TannerHollis/FestivalNecklace/Angled View.png

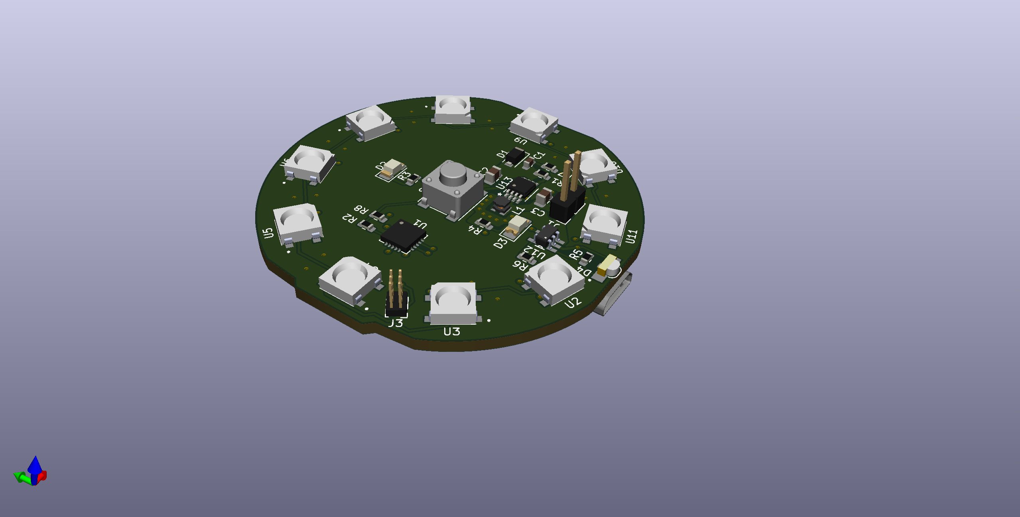
Angled View.png
