TannerHollis/FestivalNecklace/Bottom View.png

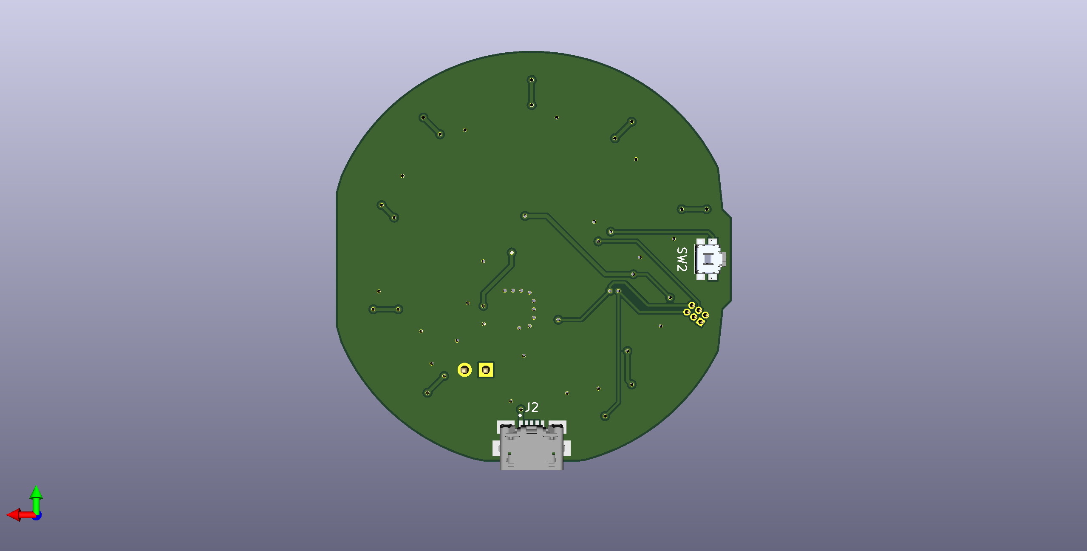
Bottom View.png
