TannerHollis/FestivalNecklace/README.md

# FestivalNecklace
 Fun RGB ATTiny Festival Necklace
