TannerHollis/FestivalNecklace/Board Dimensions.png

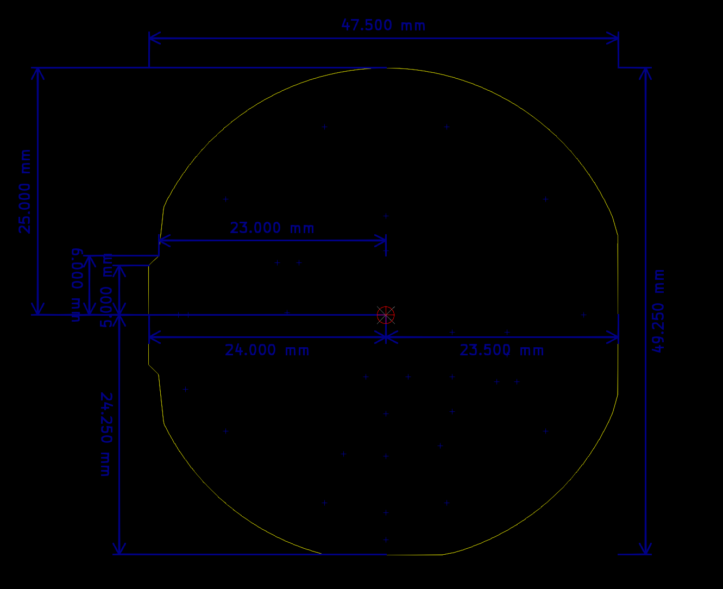
Board Dimensions.png
