TannerHollis/FestivalNecklace/Board Outline.png

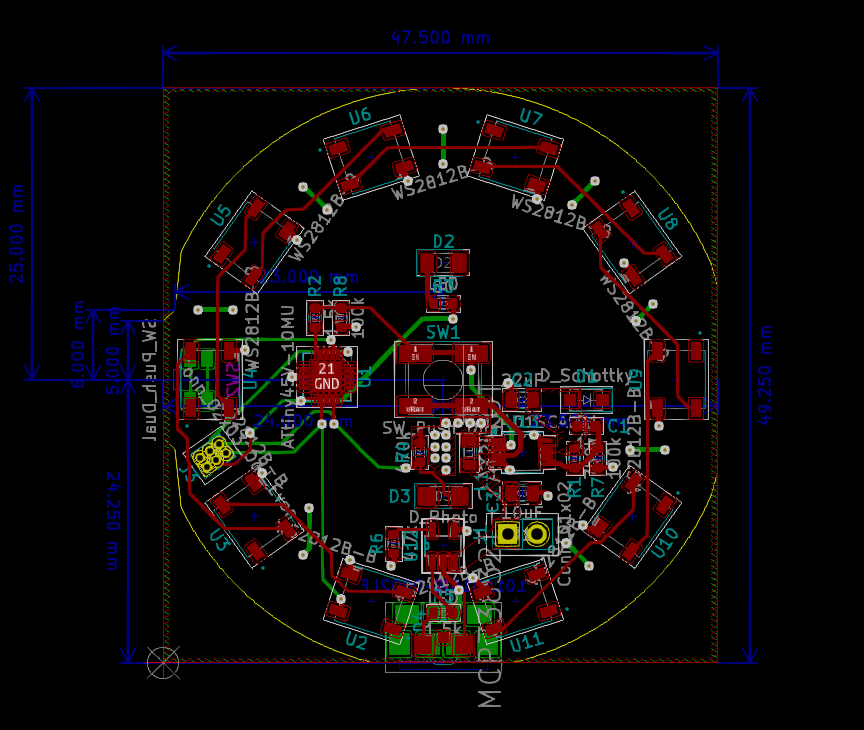
Board Outline.png
