TannerHollis/FestivalNecklace/Programmer_Pinout.jpg

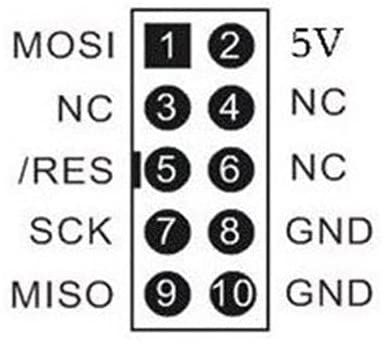
Programmer_Pinout.jpg
