TannerHollis/FestivalNecklace/Switch View.png

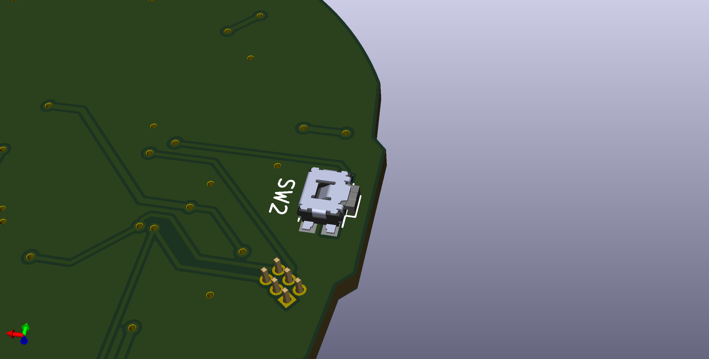
Switch View.png
