TannerHollis/FestivalNecklace/Top View.png

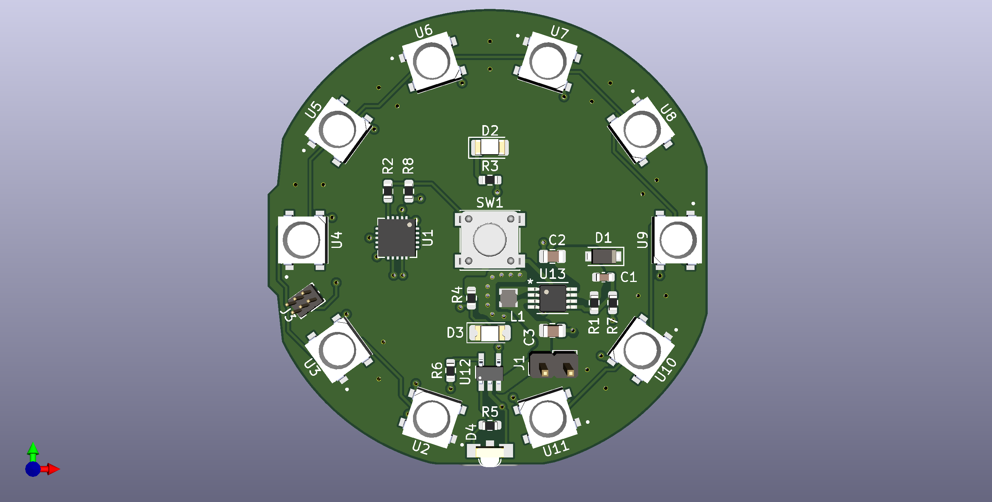
Top View.png
