TannerHollis/FestivalNecklace/FestivalNecklace_BOM_R1.xlsx

Item | Qty | Reference(s) | Value | LibPart | Footprint | DK_PN | MANUFACTURER | PARTNO | PREVIOUSLY ORDERD | AVAILABLE | PRICE | PRICE PER QUANTITY | QUANTITY NEEDED | DIGIKEY PARTNUMBER
1 | 1 | C1 | 1n | Device:C | Capacitor_SMD:C_0603_1608Metric | 1276-1018-1-ND | Samsung Electro-Mechanics | CL10B102KB8NNNC | Yes | 50 | $0.85 | $0.017
2 | 1 | C2 | 22uF | Device:C | Capacitor_SMD:C_0805_2012Metric | 1276-6460-1-ND | Samsung Electro-Mechanics | CL21A226MQQNNNG | Yes | 50 | $2.88 | $0.058
3 | 1 | C3 | 10uF | Device:C | Capacitor_SMD:C_0805_2012Metric | 1276-1298-1-ND | Samsung Electro-Mechanics | CL21A106MQFNNNE | Yes | 50 | $2.14 | $0.043
4 | 1 | D1 | D_Schottky | Device:D_Schottky | Diode_SMD:D_SOD-123F | 1727-5192-1-ND | Nexperia USA Inc. | PMEG2010ER | Yes | 50 | $15.95 | $0.319
5 | 1 | D2 | LED | Device:LED | LED_SMD:LED_1206_3216Metric | 1080-1357-1-ND | Everlight Electronics Co Ltd | IR26-21C/L110/TR8 | Yes | 100 | $9.47 | $0.095
6 | 1 | D3 | D_Photo | Device:D_Photo | LED_SMD:LED_1206_3216Metric_Castellated | 3147-B1501PD--H9B000113U1930CT-ND |  | B1501PD--H9B000113U1930 | Yes | 50 | $7.00 | $0.140
7 | 1 | D4 | LED | Device:LED | FestivalNecklace:APA3010SECK | 754-1842-1-ND | Kingbright | APA3010SECK-GX | Yes | 50 | $14.35 | $0.287
8 | 1 | J1 |  |  |  |  |  |  |  |  |  | $0.000
9 | 1 | J2 | 10118192-0002LF | FestivalNecklace:10118192-0002LF | FestivalNecklace:AMPHENOL_10118192-0002LF | 609-5379-1-ND | Amphenol ICC (FCI) | 10118192-0002LF | Yes | 25 | $8.83 | $0.353
10 | 1 | J3 |  |  |  |  |  |  |  |  |  | $0.000
11 | 1 | L1 | 2.2u | Device:L | Inductor_SMD:L_0805_2012Metric | 1292-WLPH201610M2R2PPCT-ND | Walsin Technology Corporation | WLPH201610M2R2PP | Yes | 50 | $3.78 | $0.076
12 | 1 | R1 | 750k | Device:R | Resistor_SMD:R_0603_1608Metric | RMCF0603FT750KCT-ND | Stackpole Electronics Inc | RMCF0603FT750K | Yes | 100 | $0.68 | $0.007
13 | 2 | R2, R5 | 1.5k | Device:R | Resistor_SMD:R_0603_1608Metric | 311-1.50KHRCT-ND | YAGEO | RC0603FR-071K5L | Yes | 100 | $0.97 | $0.019
14 | 1 | R3 | 47 | Device:R | Resistor_SMD:R_0603_1608Metric | 10-ERJ-H3GJ470VCT-ND | Panasonic Electronic Components | ERJ-H3GJ470V | Yes | 100 | $5.38 | $0.054
15 | 1 | R4 | 470k | Device:R | Resistor_SMD:R_0603_1608Metric | A129720CT-ND | TE Connectivity Passive Product | CRGCQ0603F470K | Yes | 100 | $1.45 | $0.014
16 | 1 | R6 | 4.7k | Device:R | Resistor_SMD:R_0603_1608Metric | RR08P4.7KDCT-ND | Susumu | RR0816P-472-D | Yes | 100 | $3.42 | $0.034
17 | 2 | R7, R8 | 100k | Device:R | Resistor_SMD:R_0603_1608Metric | CR0603-JW-104ELFCT-ND | Bourns Inc. | CR0603-JW-104ELF | Yes | 100 | $0.36 | $0.007
18 | 1 | SW1 | SW_Push_Dual | Switch:SW_SPST | FestivalNecklace:TL3301NF260QG | EG4374CT-ND | E-Switch | TL3301AF160QJ | Yes | 50 | $21.54 | $0.431
19 | 1 | SW2 | SW_Push_Dual | Switch:SW_SPST | FestivalNecklace:EVQ-P7C01P | P16765CT-ND | Panasonic Electronic Components | EVQ-P7C01P | Yes | 50 | $14.48 | $0.290
20 | 1 | U1 | ATtiny45V-10MU | MCU_Microchip_ATtiny:ATtiny45V-10MU | Package_DFN_QFN:QFN-20-1EP_4x4mm_P0.5mm_EP2.6x2.6mm | ATTINY45V-10MU-ND | Microchip Technology | ATTINY45V-10MU | Yes | 25 | $44.85 | $1.794
21 | 10 | U2, U3, U4, U5, U6, U7, U8, U9, U10, U11 | WS2812B-B | FestivalNecklace:WS2812B-B | FestivalNecklace:LED_WS2812B-B |  | Worldsemi |  | Yes | 150 | $75.00 | $5.000
22 | 1 | U12 | MCP73832T-2ACI_OT | FestivalNecklace:MCP73832T-2ACI_OT | FestivalNecklace:SOT95P270X145-5N | MCP73832T-2ACI/OTCT-ND | Microchip Technology | MCP73832T-2ACI/OT | Yes | 25 | $15.75 | $0.630
23 | 1 | U13 | PAM2401SCADJ | FestivalNecklace:PAM2401SCADJ | FestivalNecklace:PAM2401SCADJ | PAM2401SCADJDICT-ND | Diodes Incorporated | PAM2401SCADJ | Yes | 25 | $22.26 | $0.890
 |  |  |  |  |  |  |  | Subtotal |  |  | $271.39 | $10.56
