TannerHollis/FestivalNecklace/PCBWay_BOM_A0.xlsx

 |  |  | xxxx xxxx xxxxx xxPCS BOM (Sample Bill of Materials)
Item # | *Designator | *Qty | Manufacturer | *Mfg Part # | Description / Value | *Package/Footprint | Type | Your Instructions / Notes | Digikey PartNumber
1 | D1 | 1 | Nexperia USA Inc. | PMEG2010ER | D | D_SOD-123F | SMD |  | 1727-5192-1-ND
2 | U2, U3, U4, U5, U7 | 5 |  | WS2812b | RGB_LED | WS2812b (5050) | SMD
3 | D6 | 1 | Everlight Electronics Co Ltd | IR26-21C/L110/TR8 | IR_LED | LED_1206_3216Metric | SMD |  | 1080-1357-1-ND
4 | D8 | 1 | Harvatek Corporation | B1501PD--H9B000113U1930 | D_PHOTO | LED_1206_3216Metric_Castellated | SMD |  | 3147-B1501PD--H9B000113U1930TR-ND
5 | J1 | 1 |  |  | Conn_01x02 |  | THT | DNP
6 | J2 | 1 |  |  | Conn_02x03_Odd_Even |  | THT | DNP
7 | Q1 | 1 | Vishay Siliconix | SI1021R-T1-GE3 | MOSFET N-CH 20V 200MA SSM | SC-75, SOT-416 | SMD |  | SI1021R-T1-GE3CT-ND
8 | R1 | 1 | Bourns Inc. | CR0603-JW-104ELF | 100k | R_0603_1608Metric | SMD |  | CR0603-JW-104ELFCT-ND
9 | R2 | 1 | YAGEO | RC0603FR-071K5L | 1.5k | R_0603_1608Metric | SMD |  | 311-1.50KHRCT-ND
10 | R3 | 1 | Panasonic Electronic Components | ERJ-H3GJ470V | 47 | R_0603_1608Metric | SMD |  | 10-ERJ-H3GJ470VCT-ND
11 | R4 | 1 | TE Connectivity Passive Product | CRGCQ0603F470K | 470k | R_0603_1608Metric | SMD |  | A129720CT-ND
12 | SW1 | 1 | E-Switch | TL3301NF260QJ | SW_Push | TL3301NF260QG | SMD |  | EG6055CT-ND
13 | SW2 | 1 | Panasonic Electronic Components | EVQ-P7C01P | SW_Push | EVQ-P7C01P | SMD |  | P16765CT-ND
14 | U1 | 1 | Microchip Technology | ATTINY13V-10MMUR | IC MCU 8BIT 1KB FLASH 10MLP | DFN-10-1EP_3x3mm_P0.5mm_EP1.75x2.7mm | SMD |  | ATTINY13V-10MMURCT-ND
Need a quick and accurante quote? Need an efficient production? Please read SMT Ordering Necessary Files & Info in 1 minute. Thank you very much! (https://www.pcbway.com/smt_ordering_guide.html)
Click for Instructions on How to Create a BOM (https://www.pcbway.com/blog/PCB_Assembly/How_to_Build_a_BOM__Bill_Of_Materials_.html)
