TannerHollis/FestivalNecklace/PCBWay_BOM_A1.xlsx

 |  |  | FESTIVAL NECKLACE 20PCS BOM
Item # | *Designator | *Qty | Manufacturer | *Mfg Part # | Description / Value | *Package/Footprint | Type | Your Instructions / Notes | Digikey PartNumber
1 | C1 | 1 | Samsung Electro-Mechanics | CL10B102KB8NNNC | CAP CER 1000PF 50V X7R 0603 | C_0603_1608Metric | SMD |  | 1276-1018-1-ND
2 | C2 | 1 | Samsung Electro-Mechanics | CL21A226MQQNNNG | CAP CER 22UF 6.3V X5R 0805 | C_0805_2012Metric | SMD |  | 1276-6460-1-ND
3 | C3 | 1 | Samsung Electro-Mechanics | CL21A106MQFNNNE | CAP CER 10UF 6.3V X5R 0805 | C_0805_2012Metric | SMD |  | 1276-1298-1-ND
4 | D1 | 1 | Nexperia USA Inc. | PMEG2010ER | DIODE SCHOTTKY 20V 1A CFP3 | D_SOD-123F | SMD |  | 1727-5192-1-ND
5 | D2 | 1 | Everlight Electronics Co Ltd | IR26-21C/L110/TR8 | EMITTER IR 940NM 65MA 1206 | LED_1206_3216Metric | SMD |  | 1080-1357-1-ND
6 | D3 | 1 |  | B1501PD--H9B000113U1930 | Photodiode 940nm 6ns - 1206 (3216 Metric) | LED_1206_3216Metric_Castellated | SMD |  | 3147-B1501PD--H9B000113U1930CT-ND
7 | D4 | 1 | Kingbright | APA3010SECK-GX | LED ORANGE CLEAR SMD R/A | 2-SMD, No Lead | SMD |  | 754-1842-1-ND
8 | J1 | 1 |  |  |  |  | THT | DNP
9 | J2 | 1 | Amphenol ICC (FCI) | 10118192-0002LF | CONN RCPT USB2.0 MICRO B SMD R/A | USB_Micro_B-SMD | SMD |  | 609-5379-1-ND
10 | J3 | 1 |  |  |  |  | THT | DNP
11 | L1 | 1 | Taiyo Yuden | NRS2012T2R2MGJ | FIXED IND 2.2UH 1.37A 107MOHM SM | 2-SMD, No Lead | SMD |  | 587-3450-1-ND
12 | R1 | 1 | Stackpole Electronics Inc | RMCF0603FT750K | RES 750K OHM 1% 1/10W 0603 | R_0603_1608Metric | SMD |  | RMCF0603FT750KCT-ND
13 | R2, R5 | 2 | YAGEO | RC0603FR-071K5L | RES 1.5K OHM 1% 1/10W 0603 | R_0603_1608Metric | SMD |  | 311-1.50KHRCT-ND
14 | R3 | 1 | Panasonic Electronic Components | ERJ-H3GJ470V | RES 47 OHM 5% 1/8W 0603 | R_0603_1608Metric | SMD |  | 10-ERJ-H3GJ470VCT-ND
15 | R4 | 1 | TE Connectivity Passive Product | CRGCQ0603F470K | RES 470K OHM 1% 1/10W 0603 | R_0603_1608Metric | SMD |  | A129720CT-ND
16 | R6 | 1 | Susumu | RR0816P-472-D | RES SMD 4.7K OHM 0.5% 1/16W 0603 | R_0603_1608Metric | SMD |  | RR08P4.7KDCT-ND
17 | R7, R8 | 2 | Bourns Inc. | CR0603-JW-104ELF | RES SMD 100K OHM 5% 1/10W 0603 | R_0603_1608Metric | SMD |  | CR0603-JW-104ELFCT-ND
18 | SW1 | 1 | E-Switch | TL3301AF160QJ | SWITCH TACTILE SPST-NO 0.05A 12V | 6mmx6mm-SMD-Jlead | SMD |  | EG4374CT-ND
19 | SW2 | 1 | Panasonic Electronic Components | EVQ-P7C01P | SWITCH TACTILE SPST-NO 0.05A 12V | 4.7mmx2.9mm-SMD-RightAngle | SMD |  | P16765CT-ND
20 | U1 | 1 | Microchip Technology | ATTINY45V-10MU | IC MCU 8BIT 4KB FLASH 20QFN | QFN-20-1EP_4x4mm_P0.5mm_EP2.6x2.6mm | SMD |  | ATTINY45V-10MU-ND
21 | U2, U3, U4, U5, U6, U7, U8, U9, U10, U11 | 10 | Worldsemi |  |  | LED_50mmx50mm | SMD
22 | U12 | 1 | Microchip Technology | MCP73832T-2ACI/OT | IC BATT CNTL LI-ION 1CEL SOT23-5 | SOT95P270X145-5N | SMD |  | MCP73832T-2ACI/OTCT-ND
23 | U13 | 1 | Diodes Incorporated | PAM2401SCADJ | IC REG BOOST ADJUSTABLE 1A 8MSOP | 8-TSSOP, 8-MSOP | SMD |  | PAM2401SCADJDICT-ND
Need a quick and accurante quote? Need an efficient production? Please read SMT Ordering Necessary Files & Info in 1 minute. Thank you very much! (https://www.pcbway.com/smt_ordering_guide.html)
Click for Instructions on How to Create a BOM (https://www.pcbway.com/blog/PCB_Assembly/How_to_Build_a_BOM__Bill_Of_Materials_.html)
