TannerHollis/FestivalNecklace/Total_Cost.xlsx

Run | 1 | 2 | 3
PCB Cost | $48.91
Assembly Cost | $312.66
Component Costs | $348.80
Total Cost | $710.37
Number Assembled. | 20
Cost per Board | $35.52
