TannerHollis/FestivalNecklace/Components/COM-11821.step

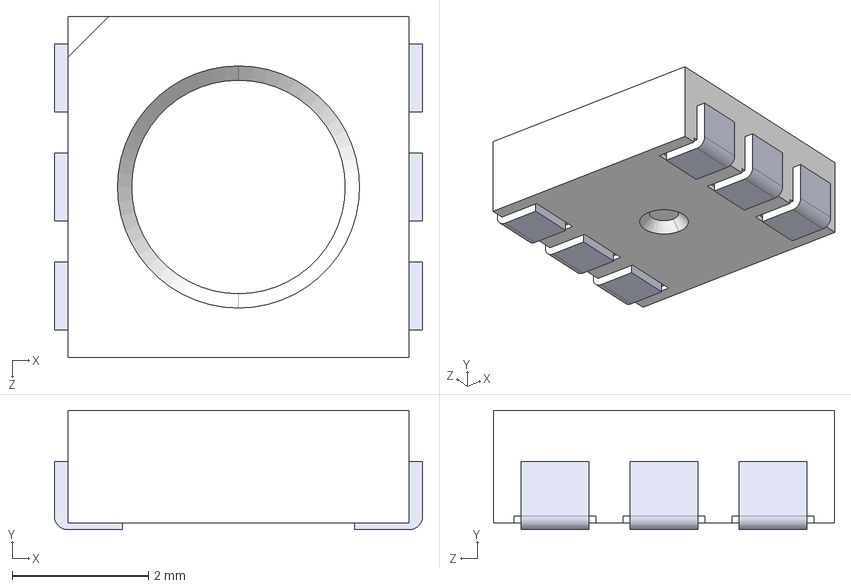
[picture p8: CAD file, 2022-07-14]
Components/COM-11821.step
5.40 x 1.75 x 5.00 mm
