TannerHollis/FestivalNecklace/Components/APA3010.STEP

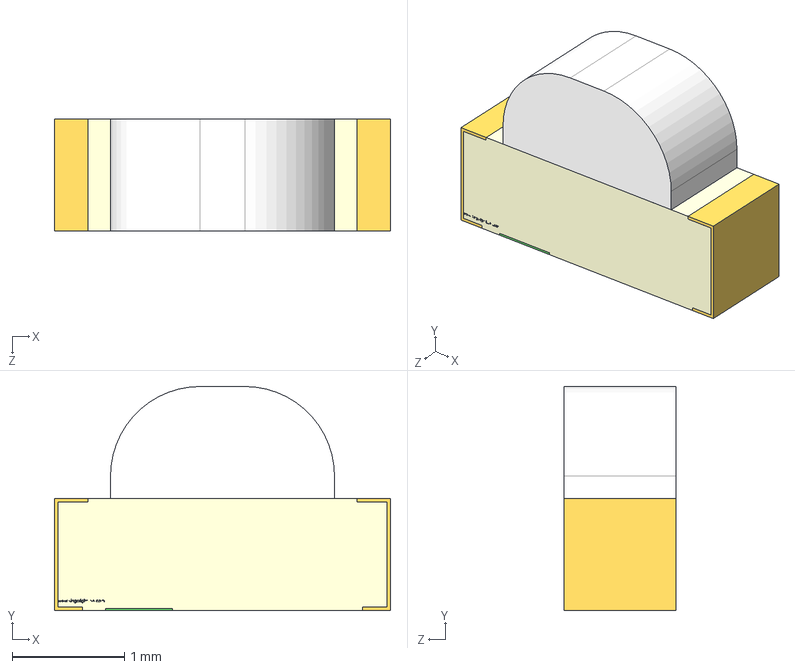
[picture p9: CAD file, 2022-07-14]
Components/APA3010.STEP
3.00 x 2.00 x 1.00 mm
