TannerHollis/FestivalNecklace/Components/EVQ-P7J01P--3DModel-STEP-56544.STEP

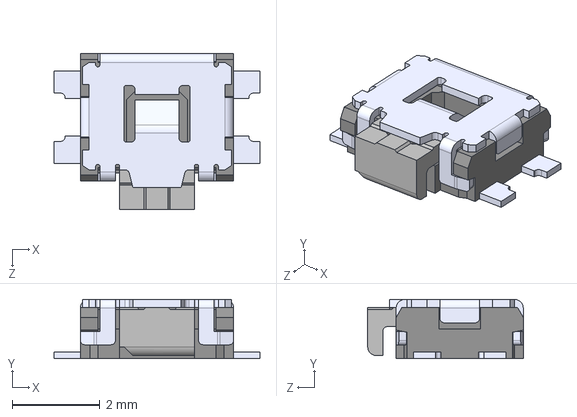
[picture p10: CAD file, 2022-07-14]
Components/EVQ-P7J01P--3DModel-STEP-56544.STEP
4.70 x 1.35 x 3.55 mm
