TannerHollis/FestivalNecklace/Components/WS2812B-B.step

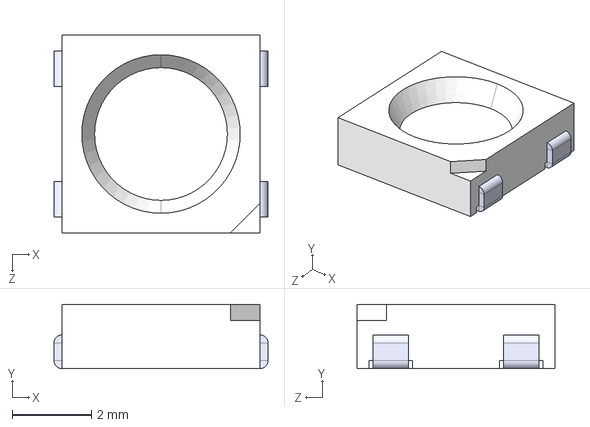
[picture p11: CAD file, 2022-07-14]
Components/WS2812B-B.step
5.40 x 1.62 x 5.00 mm
