TannerHollis/FestivalNecklace/Components/TL3301AFxxxxJ.stp

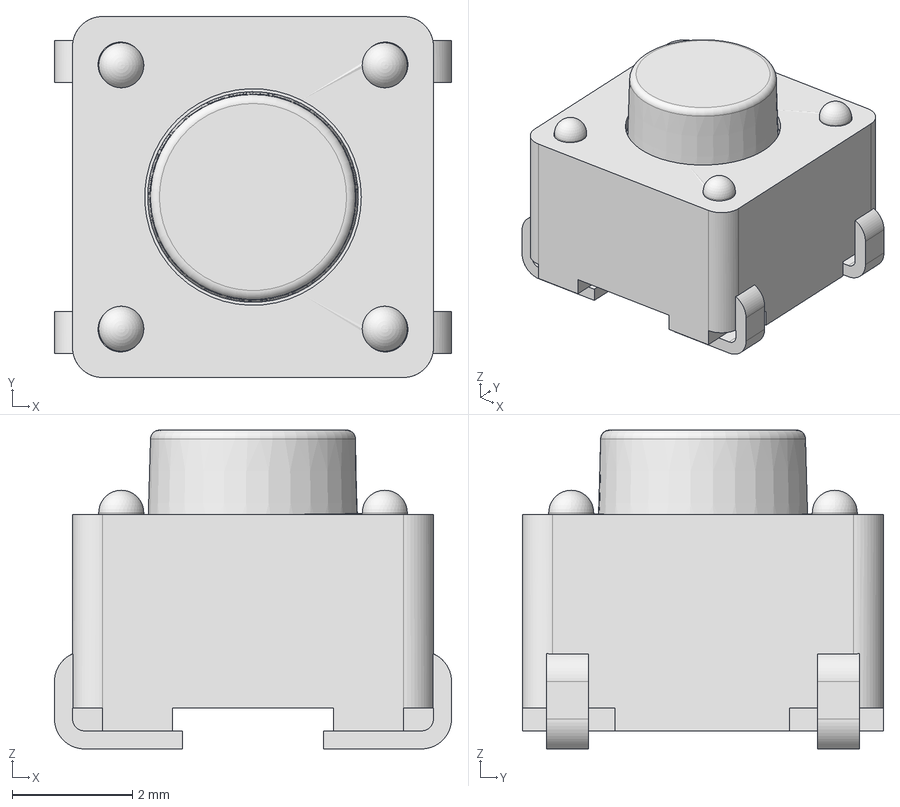
[picture p12: CAD file, 2022-07-14]
Components/TL3301AFxxxxJ.stp
6.60 x 6.00 x 5.30 mm
