TannerHollis/FestivalNecklace/Components/10118192-0002LF.step

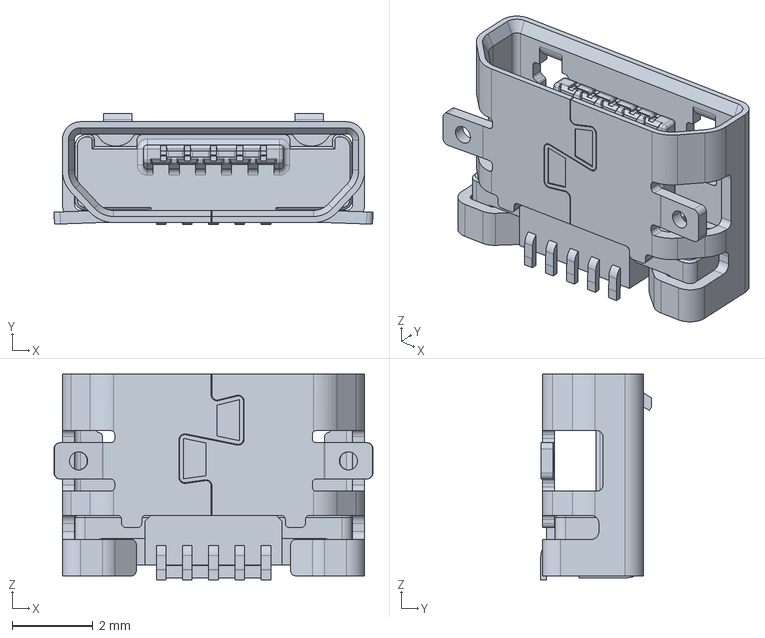
[picture p13: CAD file, 2022-07-14]
Components/10118192-0002LF.step
7.91 x 2.77 x 5.10 mm
