TannerHollis/FestivalNecklace/Components/MCP73832T-2ACI_OT.step

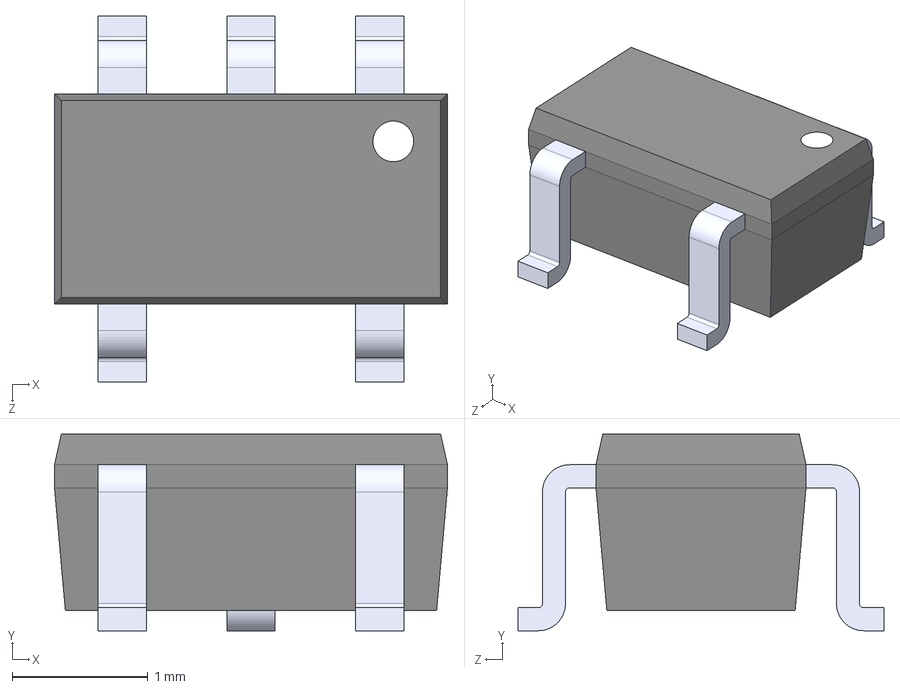
[picture p14: CAD file, 2022-07-14]
Components/MCP73832T-2ACI_OT.step
2.90 x 1.45 x 2.70 mm
