TannerHollis/FestivalNecklace/FestivalNecklace_R0.pdf

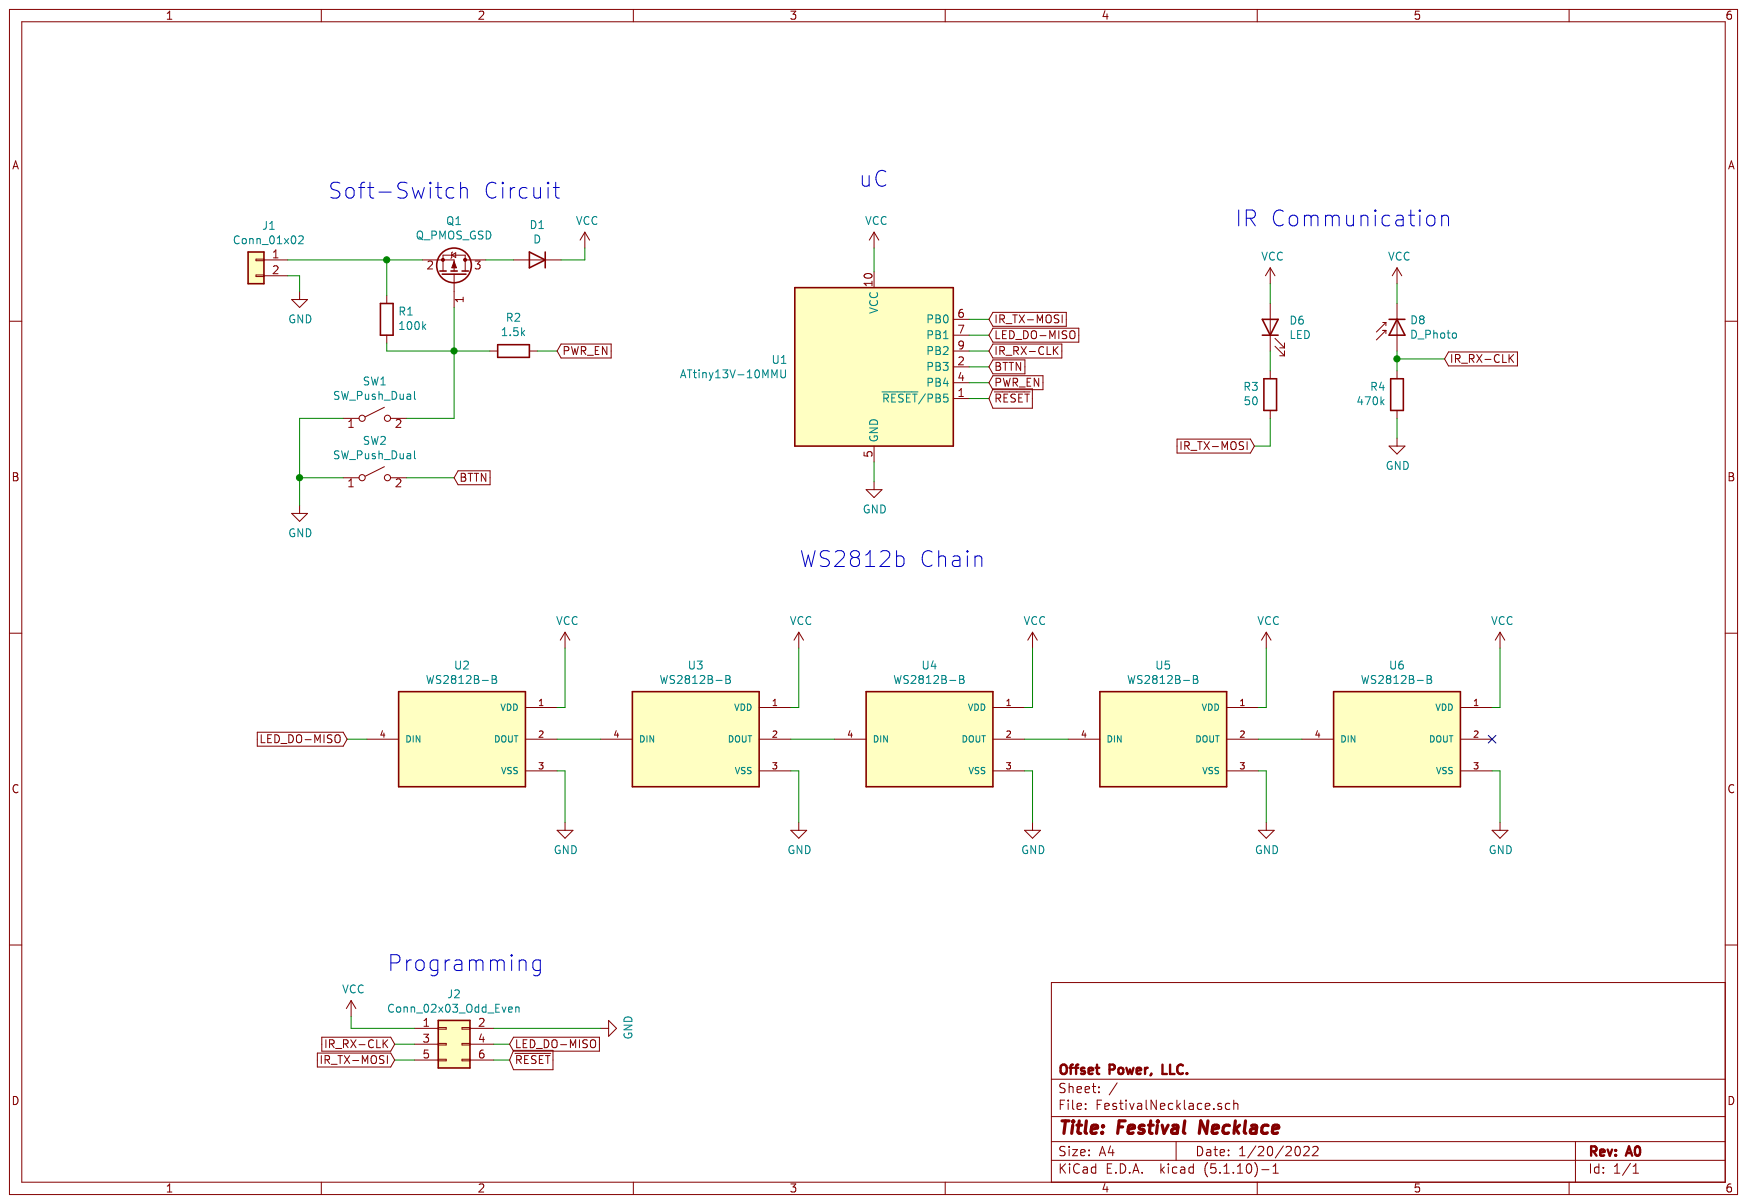
[picture p15: page 1]
