TannerHollis/FestivalNecklace/FestivalNecklace_R1.pdf

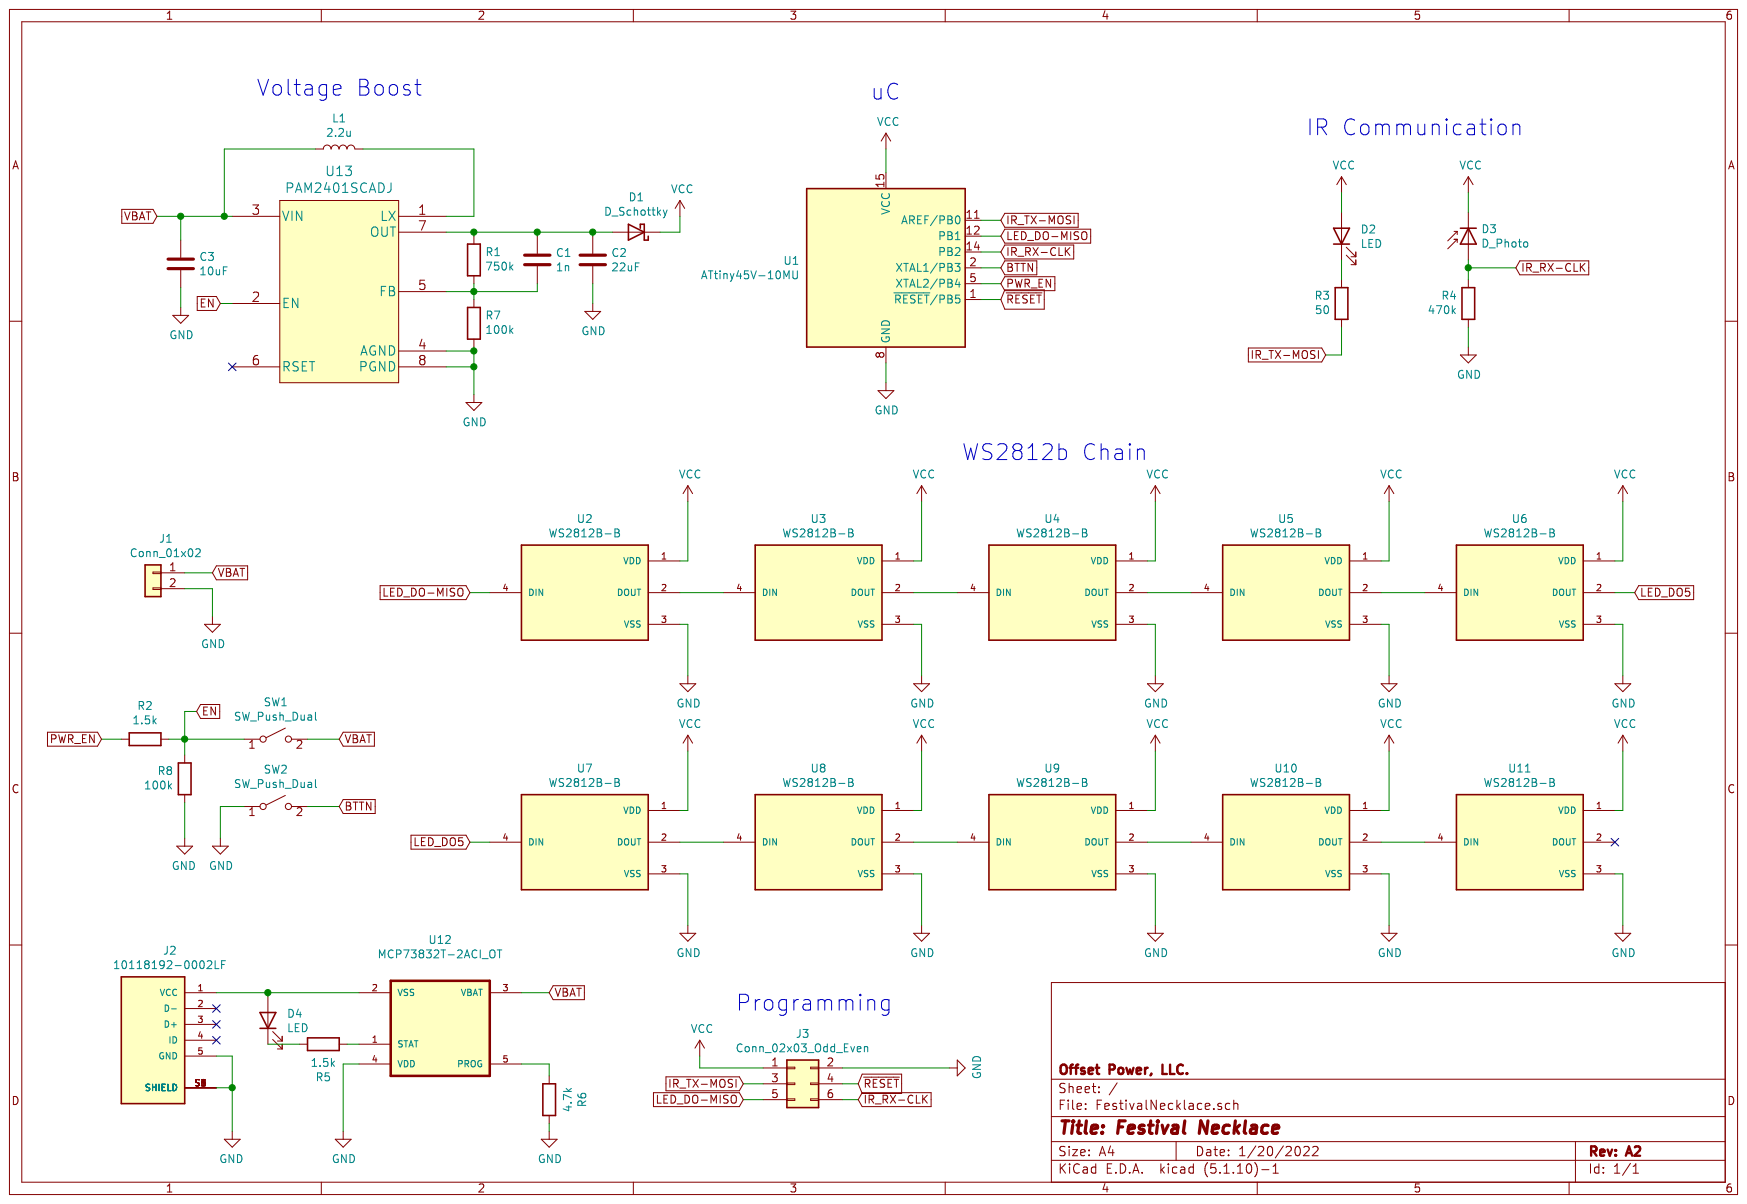
[picture p16: page 1]
