TannerHollis/FestivalNecklace/FestivalNecklace.kicad_pcb

## KiCad design FestivalNecklace.kicad_pcb (2022-07-14)

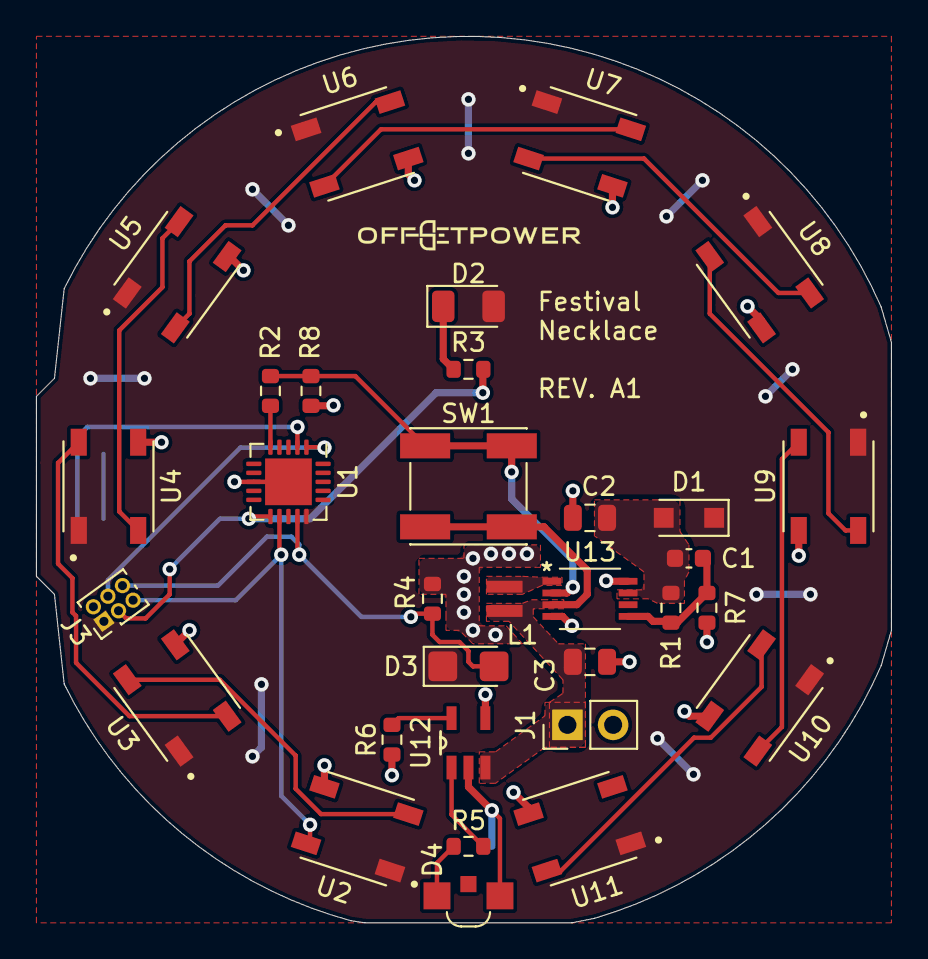
[picture p17: board FestivalNecklace.kicad_pcb from above]

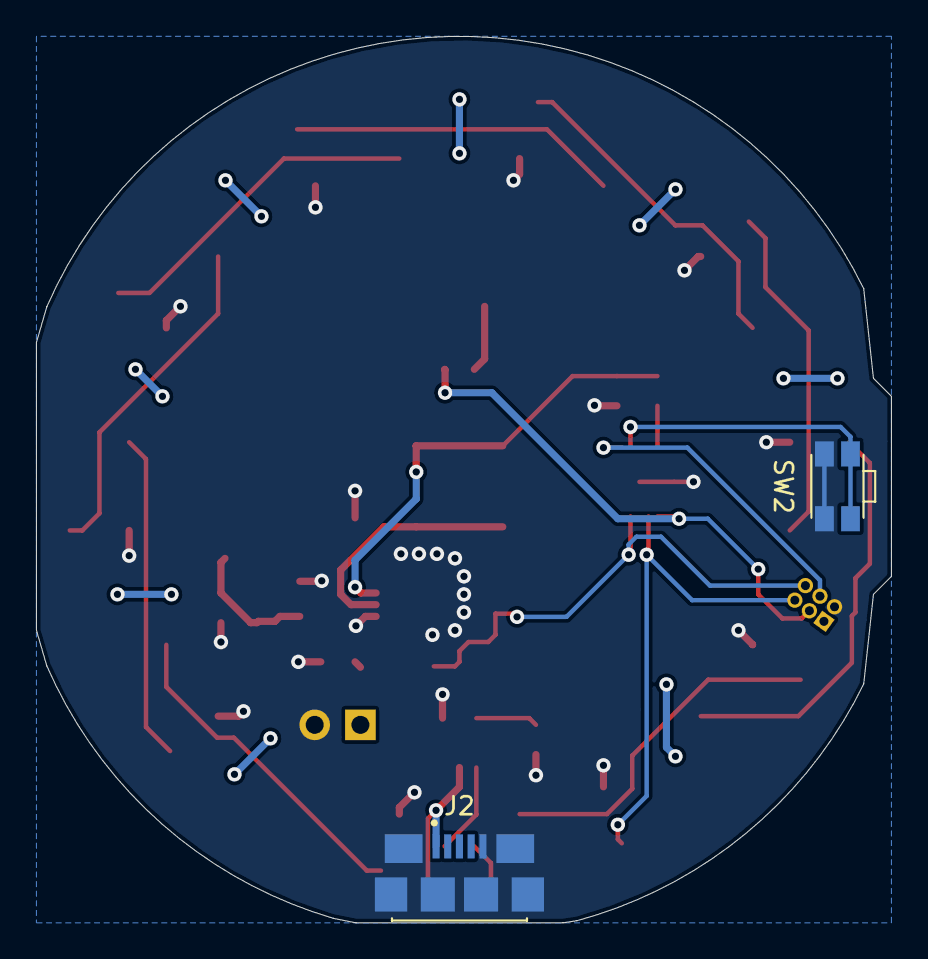
[picture p18: board FestivalNecklace.kicad_pcb from below]

Board: 2 copper layers, 47.5 x 49.2 mm, 34 parts (2 on the bottom side), 27 nets.

Parts:
C1: 1n; C_0603_1608Metric
C2: 22uF; C_0805_2012Metric
C3: 10uF; C_0805_2012Metric
D1: D_Schottky; D_SOD-123F
D2: LED; LED_1206_3216Metric
D3: D_Photo; LED_1206_3216Metric_Castellated
D4: LED; APA3010SECK
J1: Conn_01x02; PinHeader_1x02_P2.54mm_Vertical
J2: 10118192-0002LF; AMPHENOL_10118192-0002LF
J3: Conn_02x03_Odd_Even; PinHeader_2x03_P1.00mm_Vertical
L1: 2.2u; NRS2012T2R2MGJ
R1: 750k; R_0603_1608Metric
R2, R5: 1.5k; R_0603_1608Metric
R3: 50; R_0603_1608Metric
R4: 470k; R_0603_1608Metric
R6: 4.7k; R_0603_1608Metric
R7, R8: 100k; R_0603_1608Metric
SW1: SW_Push_Dual; TL3301NF260QG
SW2: SW_Push_Dual; EVQ-P7C01P
U1: ATtiny45V-10MU; QFN-20-1EP_4x4mm_P0.5mm_EP2.6x2.6mm
U2, U3, U4, U5, U6, U7, U8, U9, U10, U11: WS2812B-B; LED_WS2812B-B
U12: MCP73832T-2ACI_OT; SOT95P270X145-5N
U13: PAM2401SCADJ

Connections:
BTTN: SW2.2, U1.2
EN: R2.2, R8.2, SW1.1, U13.2
GND: C2.2, C3.2, J1.2, J2.5, J2.S1, J2.S2, J2.S3, J2.S4, J2.S5, J2.S6, J3.2, R4.1, R6.1, R7.1, R8.1, SW2.1, U1.8, U1.21, U2.3, U3.3, U4.3, U5.3, U6.3, U7.3, U8.3, U9.3, U10.3, U11.3, U12.4, U13.4, U13.8
IR_RX-CLK: D3.2, J3.6, R4.2, U1.14
IR_TX-MOSI: J3.3, R3.1, U1.11
LED_DO5: U6.2, U7.4
LED_DO-MISO: J3.5, U1.12, U2.4
unnamed: C1.1, C2.1, D1.2, R1.2, U13.7
unnamed: C1.2, R1.1, R7.2, U13.5
unnamed: D2.1, R3.2
unnamed: D4.1, R5.1
unnamed: D4.2, J2.1, U12.2
unnamed: L1.2, U13.1
unnamed: R5.2, U12.1
unnamed: R6.2, U12.5
unnamed: U2.2, U3.4
unnamed: U3.2, U4.4
unnamed: U4.2, U5.4
unnamed: U5.2, U6.4
unnamed: U7.2, U8.4
unnamed: U8.2, U9.4
unnamed: U10.2, U11.4
unnamed: U9.2, U10.4
PWR_EN: R2.1, U1.5
VBAT: C3.1, J1.1, L1.1, SW1.2, U12.3, U13.3
VCC: D1.1, D2.2, D3.1, J3.1, U1.15, U2.1, U3.1, U4.1, U5.1, U6.1, U7.1, U8.1, U9.1, U10.1, U11.1
~RESET~: J3.4, U1.1
